AryA-65/smart-stat/renodus/Pictures/renodus_front.png

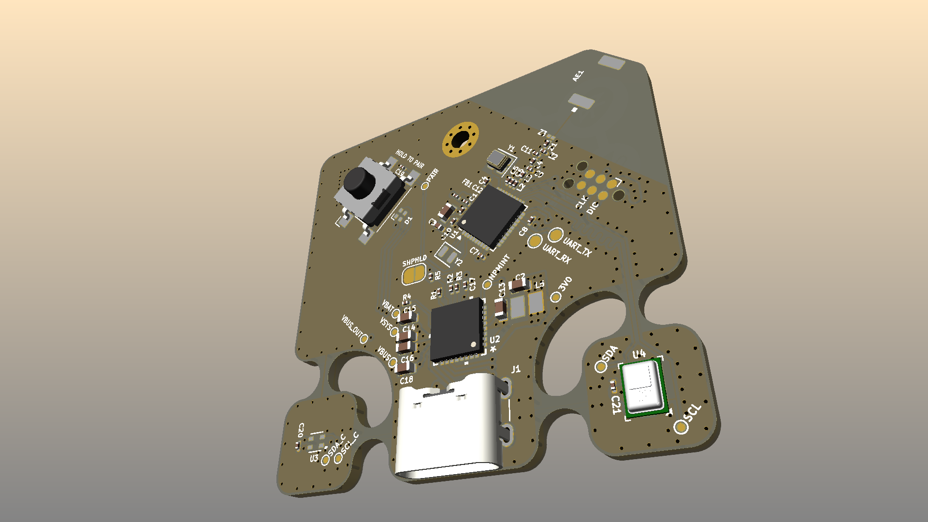
renodus/Pictures/renodus_front.png
