AryA-65/smart-stat/renodus/Pictures/renodus_back.png

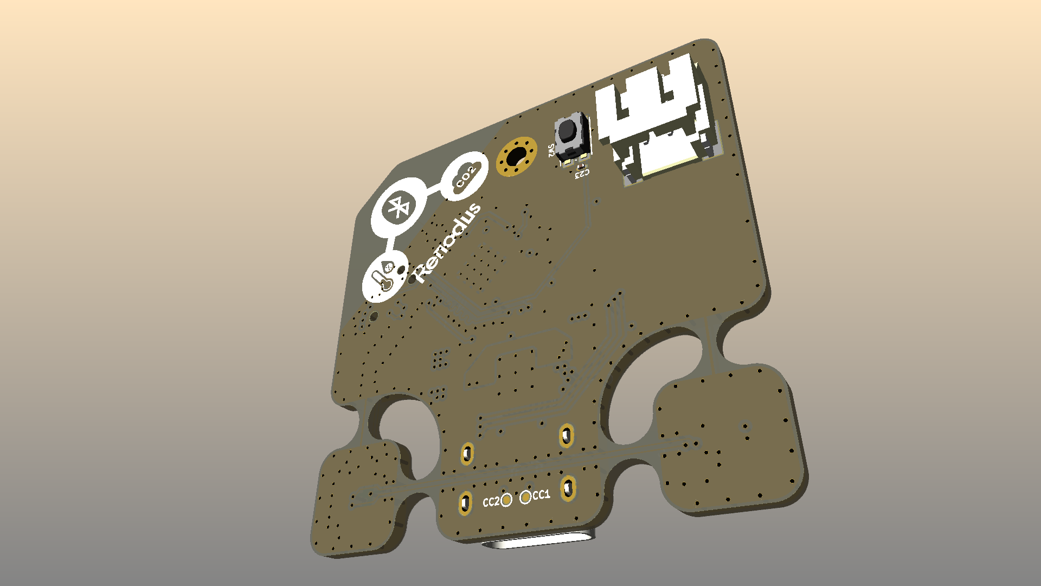
renodus/Pictures/renodus_back.png
