AryA-65/smart-stat/README.md

# smart-stat
Smart thermostat and bluetooth temperature sensors
