AryA-65/smart-stat/renodus/board.step

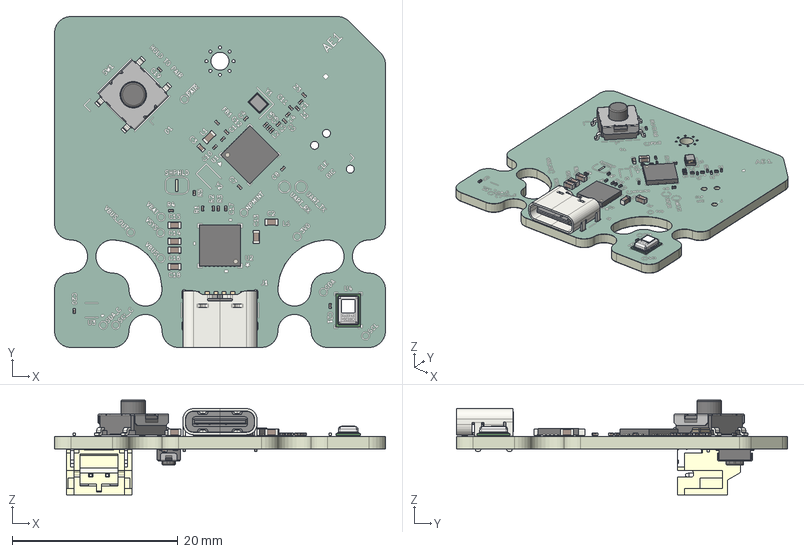
[picture p3: CAD file, 2026-07-10]
renodus/board.step
40.0 x 40.0 x 11.5 mm
C_0201_0603Metric x 27
C_0603_1608Metric x 7
USB_C_Receptacle_GCT_USB4125-xx-x_6P_TopMnt_Horizontal
Manoun_B01_BOARD_00
NYOS_BOND_8PADS_Nyos_ASIC-1_00
167450_Standard
167449_Standard
QFN-32-1EP_5x5mm_P0.5mm_EP3.7x3.7mm
QFN-40-1EP_5x5mm_Pitch0.4mm
SW_SPST_Omron_B3FS-101xP
Crystal_SMD_2016-4Pin_2.0x1.6mm
C_0402_1005Metric
SW_Push_1P1T_NO_CK_KMR2
S2B-PH-SM4-TB(LF)(SN)
renodus-unsaved-export-K5br5I_silkscreen x 2
renodus-unsaved-export-K5br5I_soldermask x 2
renodus-unsaved-export-K5br5I_PCB
