AryA-65/smart-stat/renodus/Production Files/3D Files/Button.3mf

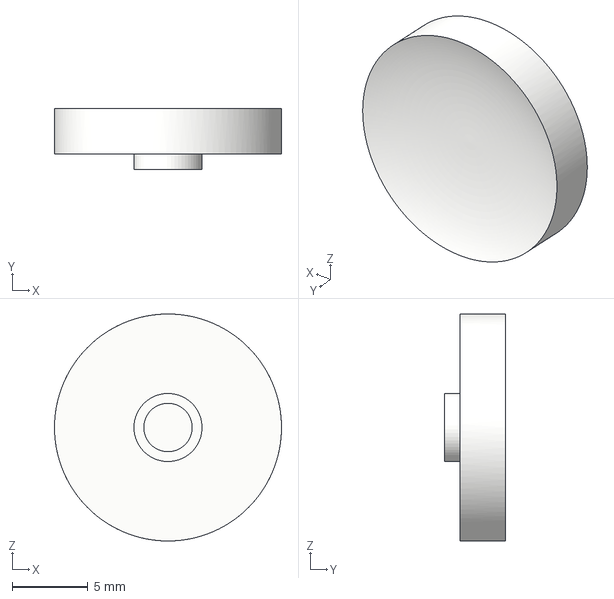
[picture p4: CAD file, 2026-07-21]
renodus/Production Files/3D Files/Button.3mf
15.0 x 4.00 x 15.0 mm
