AryA-65/smart-stat/renodus/Production Files/3D Files/Body (Rear).3mf

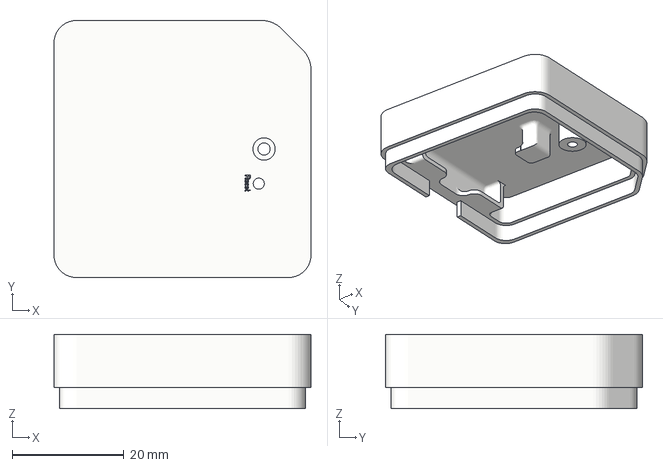
[picture p5: CAD file, 2026-07-10]
renodus/Production Files/3D Files/Body (Rear).3mf
46.0 x 46.0 x 13.3 mm
