AryA-65/smart-stat/renodus/Production Files/3D Files/Body (Front).3mf

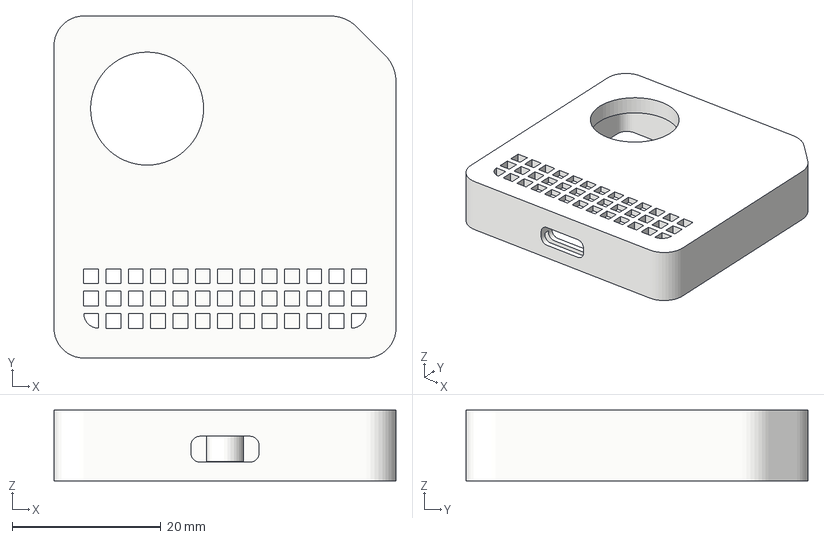
[picture p6: CAD file, 2026-07-10]
renodus/Production Files/3D Files/Body (Front).3mf
46.0 x 46.0 x 9.50 mm
