AryA-65/smart-stat/renodus/Production Files/renodus_schematic.pdf

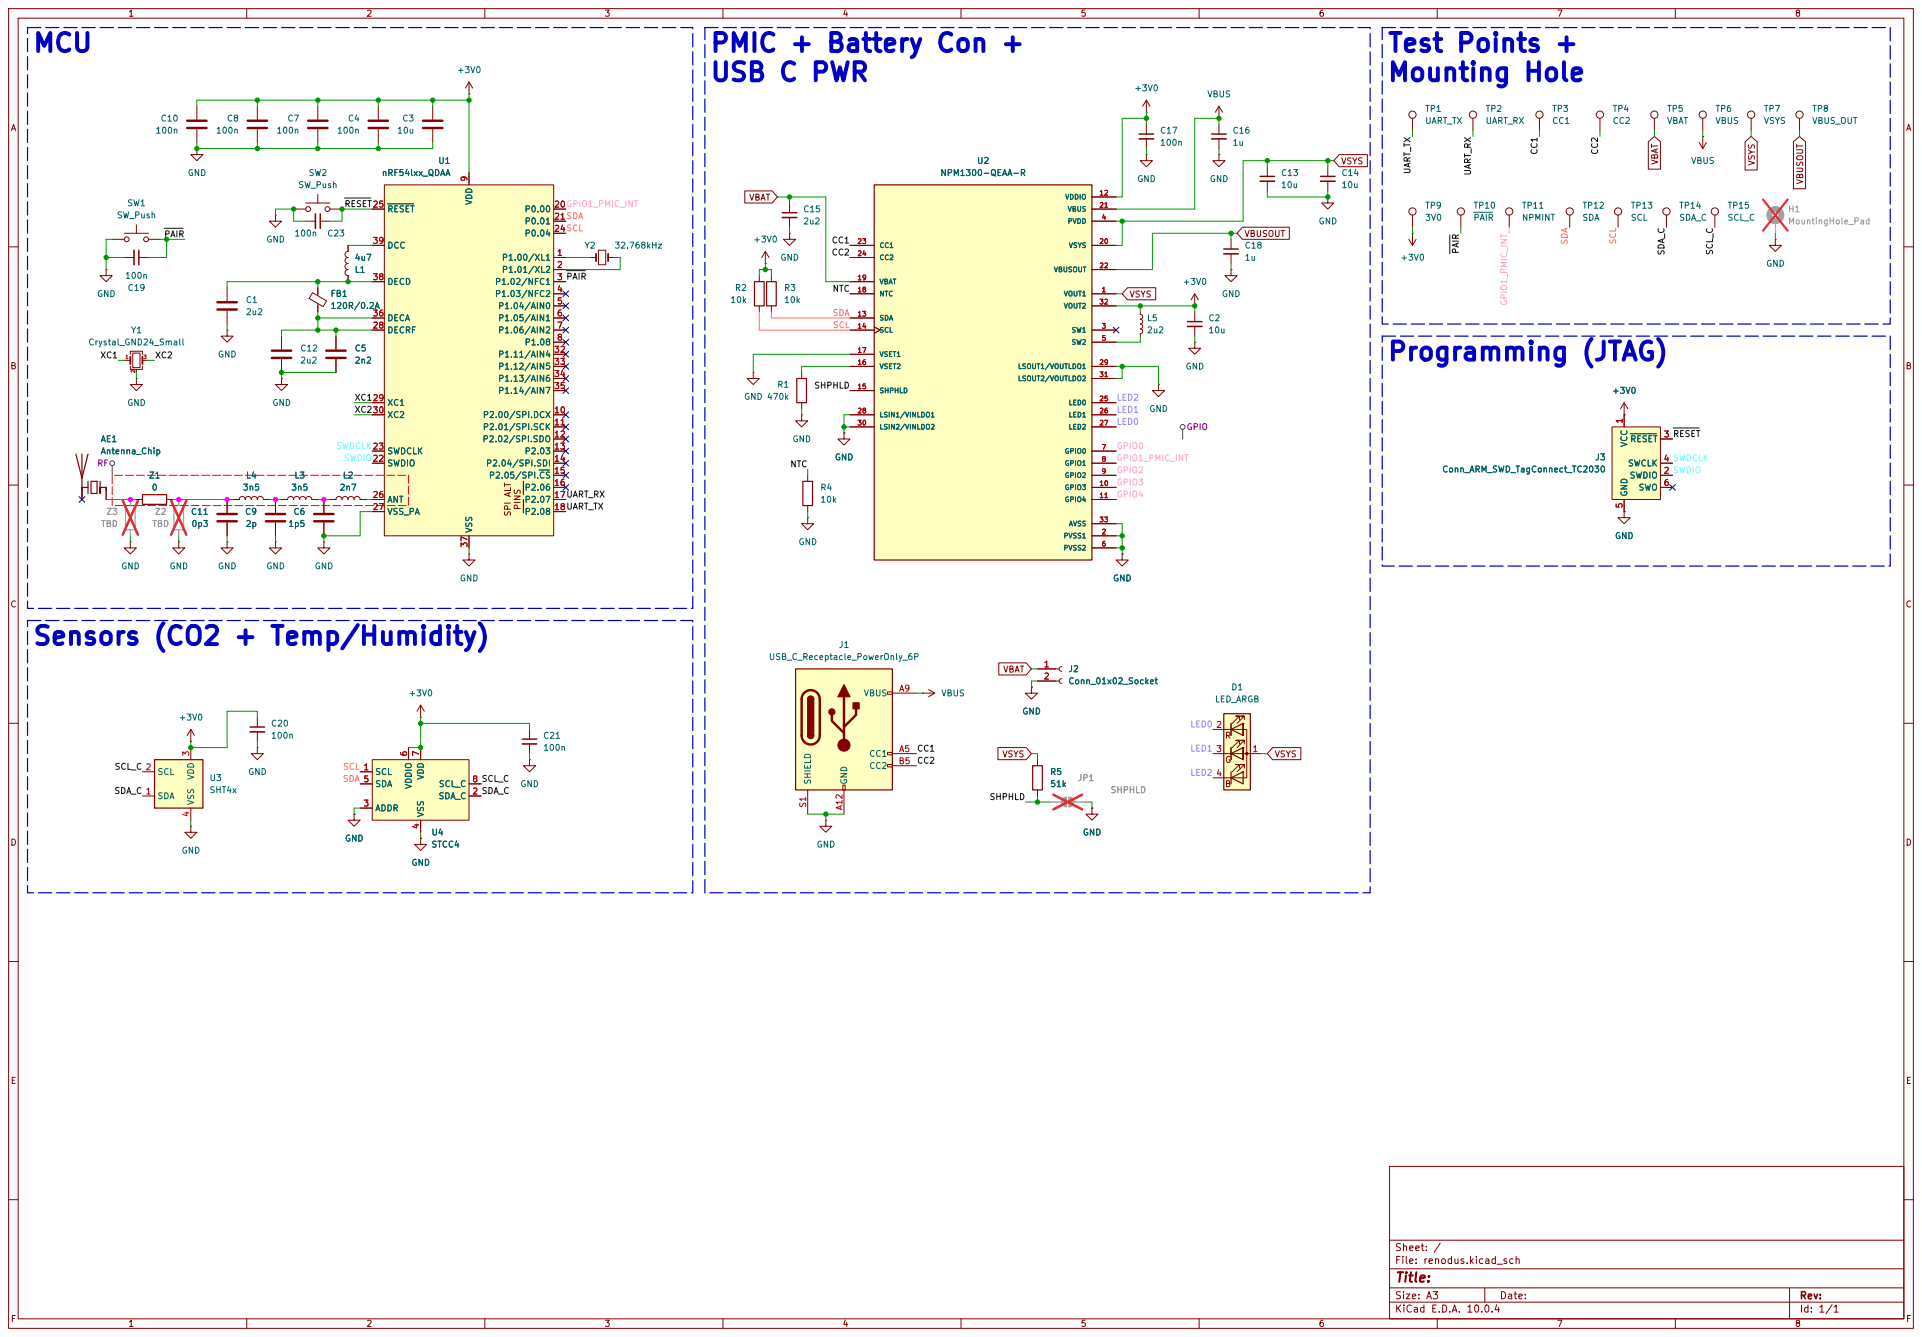
[picture p7: page 1]

9 P2.00/SPI.DCX 10 P2.01/SPI.SCK 11 P2.02/SPI.SDO 12 P2.03 13 P2.04/SPI.SDI 14 P2.05/SPI.CS 15 P2.06 16 P2.07 17 P2.08 18 P0.00 20 P0.01 21

Size: A3 | Rev: | F Date:
KiCad E.D.A. 10.0.4 | Id: 1/1
