AryA-65/smart-stat/renodus/renodus.kicad_pcb

## KiCad design renodus/renodus.kicad_pcb (2026-07-21)

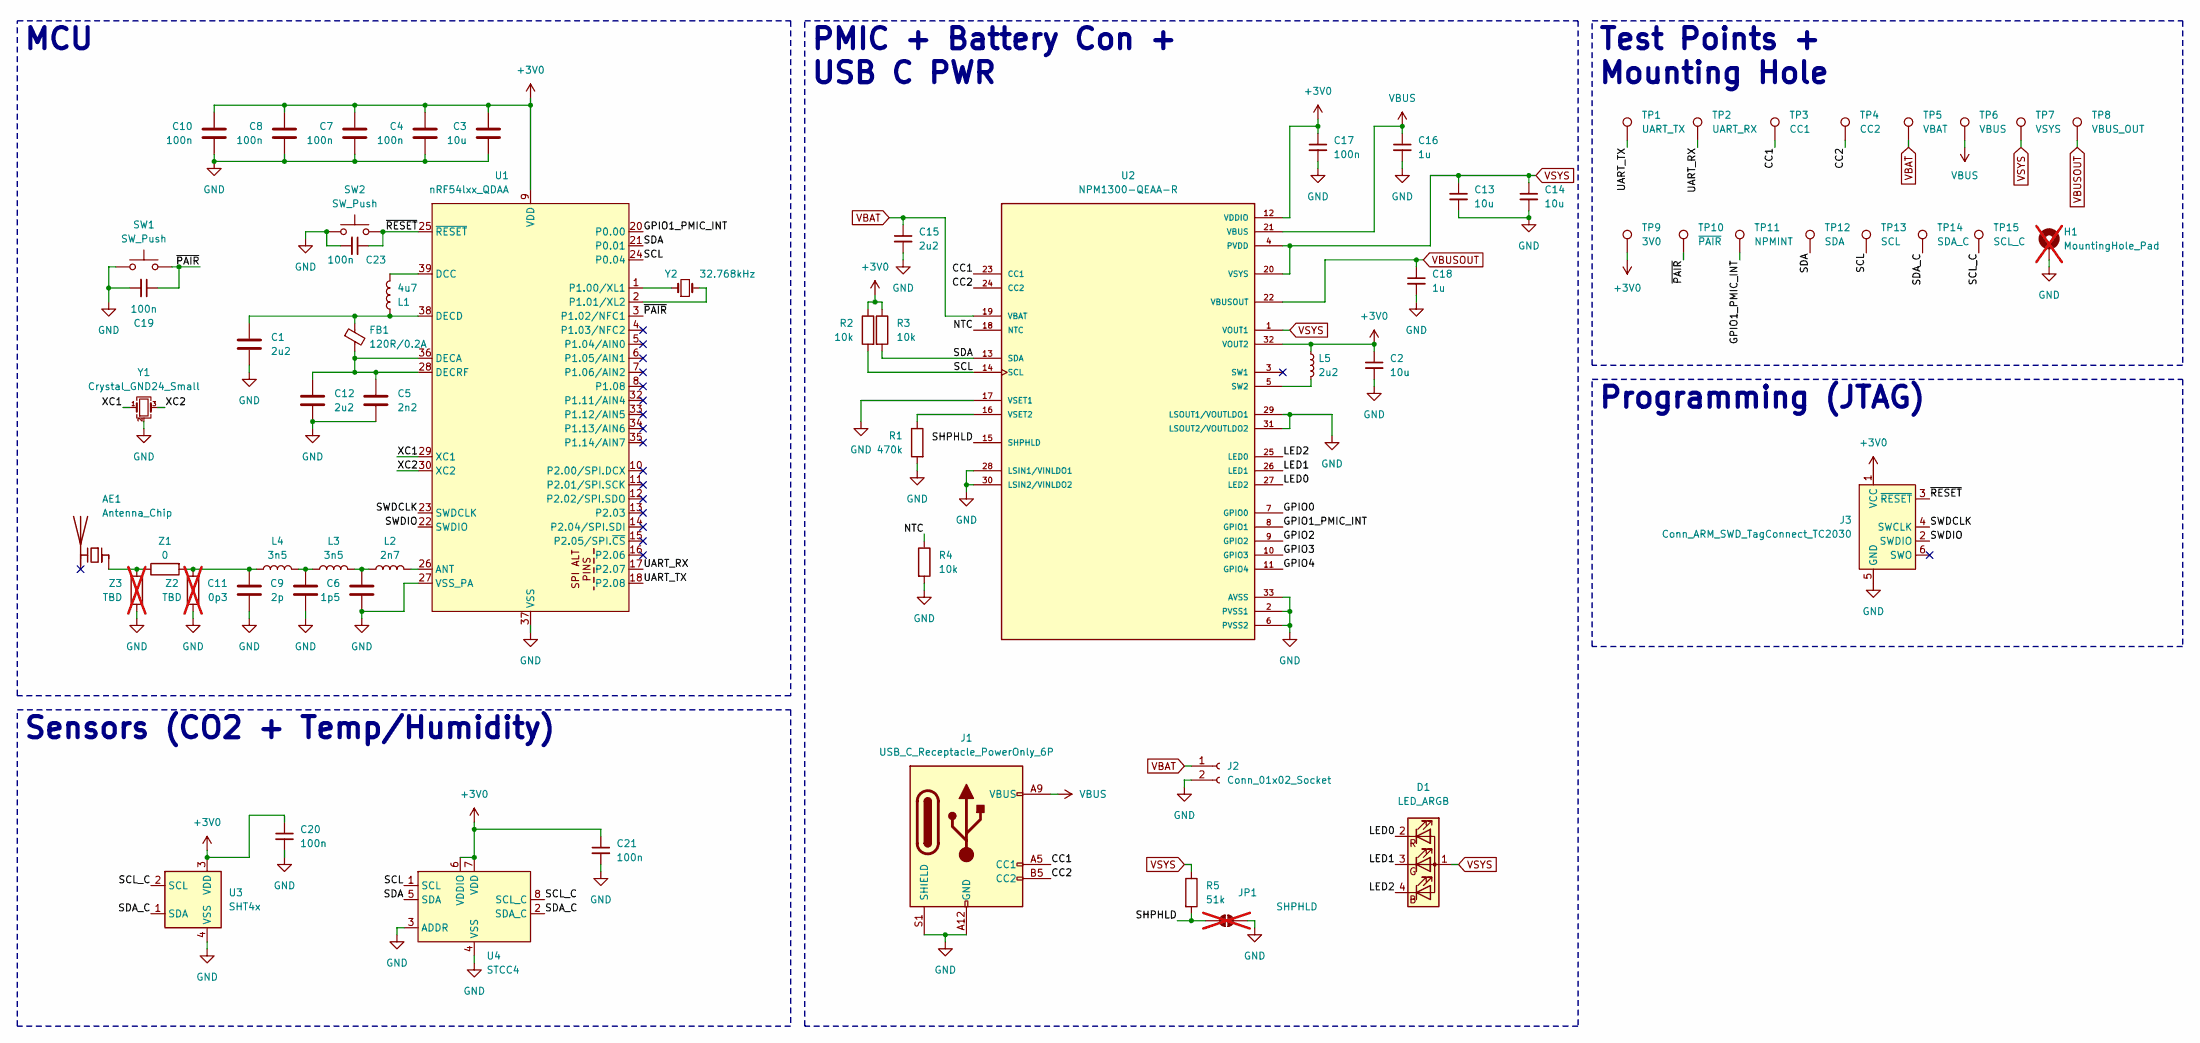
[picture p8: schematic renodus.kicad_sch]

Parts:
AE1: Antenna_Chip; AANI-CH-0129-T; Part Num. AANI-CH-0129-T
C1, C12: 2u2; 0201_universal; Part Num. GRM033R61A225KE47
C2, C13, C14: 10u; 0603_universal; Part Num. GRM188R61A106ME69J
C3: 10u; 0402_universal; Part Num. GRT155C80J106ME13J
C4, C7, C8, C10: 100n; 0201_universal; Part Num. GRM033Z71A104KE14D
C5: 2n2; 0201_universal; Part Num. GRM033R71A222KA01D
C6: 1p5; 0201_universal; Part Num. GJM0335C1E1R5WB01
C9: 2p; 0201_universal; Part Num. GJM0335C1E2R0WB01
C11: 0p3; 0201_universal; Part Num. GRM0335C1HR30BA01
C15: 2u2; 0603_universal; Part Num. GRM188R61E225KA12D
C16, C18: 1u; 0603_universal; Part Num. CL10A105KP8NNNC
C17, C19, C20, C21, C23: 100n; 0201_universal; Part Num. C0603X5R1E104K030BB
D1: LED_ARGB; LED_Wurth_150044M155260; Part Num. 150044M155260
FB1: 120R/0.2A; 0201_universal; Part Num. BLM03AG121SN1D
H1: MountingHole_Pad; MountingHole_2.2mm_M2_Pad_Via; not fitted
J1: USB_C_Receptacle_PowerOnly_6P; USB_C_Receptacle_GCT_USB4125-xx-x-0190_6P_TopMnt_Horizontal; Part Num. USB4125-GF-A
J2: Conn_01x02_Socket; JST_S2B-PH-SM4-TB; Part Num. S2B-PH-SM4-TB
J3: Conn_ARM_SWD_TagConnect_TC2030; Tag-Connect_TC2030-IDC-NL_2x03_P1.27mm_Vertical
JP1: SHPHLD; SolderJumper-2_P1.3mm_Open_RoundedPad1.0x1.5mm; not fitted
L1: 4u7; 0603_universal; Part Num. MLZ1608M4R7WT000
L2: 2n7; 0201_universal; Part Num. LQP03HQ2N7B02
L3, L4: 3n5; 0201_universal; Part Num. LQP03HQ3N5B02
L5: 2u2; INDC2016X100N; Part Num. CIGT201610EH2R2MNE
R1: 470k; 0201_universal; Part Num. ERJ-1GNF4703C
R2, R3, R4: 10k; 0201_universal; Part Num. RC0201FR-0710KL
R5: 51k; 0201_universal; Part Num. RC0201JR-0751KL
SW1: SW_Push; SW_SPST_Omron_B3FS-101xP; Part Num. B3FS-1012P
SW2: SW_Push; SW_Push_1P1T_NO_CK_KMR2; Part Num. KMR231G LFS
TP1: UART_TX; TestPoint_Pad_D1.0mm
TP2: UART_RX; TestPoint_Pad_D1.0mm
TP3: CC1; TestPoint_Pad_D0.5mm
TP4: CC2; TestPoint_Pad_D0.5mm
TP5: VBAT; TestPoint_Pad_D0.5mm
TP6: VBUS; TestPoint_Pad_D0.5mm
TP7: VSYS; TestPoint_Pad_D0.5mm
TP8: VBUS_OUT; TestPoint_Pad_D0.5mm
TP9: 3V0; TestPoint_Pad_D0.5mm
TP10: ~{PAIR}; TestPoint_Pad_D0.5mm
TP11: NPMINT; TestPoint_Pad_D0.5mm
TP12: SDA; TestPoint_Pad_D0.5mm
TP13: SCL; TestPoint_Pad_D0.5mm
TP14: SDA_C; TestPoint_Pad_D0.5mm
TP15: SCL_C; TestPoint_Pad_D0.5mm
U1: nRF54lxx_QDAA; QFN-40-1EP_5x5mm_P0.4mm_EP3.6x3.6mm_ThermalVias; Part Num. NRF54L10-QDAA-R7
U2: NPM1300-QEAA-R; QFN32_5X5_NOR-L; PARTREV v1.1
U3: SHT4x; Sensirion_DFN-4_1.5x1.5mm_P0.8mm_SHT4x_NoCentralPad; Part Num. SHT41A-AW1B-R3
U4: STCC4; Part Num. STCC4-D-R3
Y1: Crystal_GND24_Small; Crystal_SMD_2016-4Pin_2.0x1.6mm; Part Num. CX2016DB32000D0WZRC1
Y2: 32.768kHz; Crystal_SMD_2012-2Pin_2.0x1.2mm; Part Num. 9HT11-32.768KDZC-T
Z1: 0; 0201_universal; Part Num. RC0201JR-070RL
Z2, Z3: TBD; 0201_universal; not fitted

Connections:
+3V0: C2.1, C3.1, C4.1, C7.1, C8.1, C10.1, C17.1, C20.1, C21.1, J3.1 (VCC), L5.1, R2.1, R3.1, TP9.1 (1_1), U1.9 (VDD), U1.19 (VDD), U1.31 (VDD), U1.40 (VDD), U2.12 (VDDIO), U2.32 (VOUT2), U3.3 (VDD), U4.6 (VDDIO), U4.7 (VDD)
/CC1: J1.A5 (CC1), TP3.1 (1_1), U2.23 (CC1)
/CC2: J1.B5 (CC2), TP4.1 (1_1), U2.24 (CC2)
/GPIO0: U2.7 (GPIO0)
/GPIO1_PMIC_INT: TP11.1 (1_1), U1.20 (P0.00), U2.8 (GPIO1)
/GPIO2: U2.9 (GPIO2)
/GPIO3: U2.10 (GPIO3)
/GPIO4: U2.11 (GPIO4)
/LED0: D1.2 (RK), U2.27 (LED2)
/LED1: D1.3 (GK), U2.26 (LED1)
/LED2: D1.4 (BK), U2.25 (LED0)
/NTC: R4.1, U2.18 (NTC)
/SCL: R2.2, TP13.1 (1_1), U1.24 (P0.04), U2.14 (SCL), U4.1 (SCL)
/SCL_C: TP15.1 (1_1), U3.2 (SCL), U4.8 (SCL_C)
/SDA: R3.2, TP12.1 (1_1), U1.21 (P0.01), U2.13 (SDA), U4.5 (SDA)
/SDA_C: TP14.1 (1_1), U3.1 (SDA), U4.2 (SDA_C)
/SHPHLD: JP1.1 (A), R5.2, U2.15 (SHPHLD)
/SWDCLK: J3.4 (SWCLK), U1.23 (SWDCLK)
/SWDIO: J3.2 (SWDIO), U1.22 (SWDIO)
/UART_RX: TP2.1 (1_1), U1.17 (P2.07)
/UART_TX: TP1.1 (1_1), U1.18 (P2.08)
/XC1: U1.29 (XC1), Y1.1
/XC2: U1.30 (XC2), Y1.3
/~PAIR: C19.1, SW1.2, TP10.1 (1_1), U1.3 (P1.02/NFC1)
/~RESET: C23.1, J3.3 (~RESET), SW2.2, U1.25 (~RESET)
GND: C1.2, C2.2, C3.2, C4.2, C5.2, C6.2, C7.2, C8.2, C9.2, C10.2, C11.2, C12.2, C13.2, C14.2, C15.2, C16.2, C17.2, C18.2, C19.2, C20.2, C21.2, C23.2, H1.1 (1_1), J1.A12 (GND), J1.B12 (GND), J1.S1 (SHIELD), J2.2, J3.5 (GND), JP1.2 (B), R1.2, R4.2, SW1.1, SW2.1, U1.27 (VSS_PA), U1.37 (VSS), U1.41 (VSS), U2.2 (PVSS1), U2.6 (PVSS2), U2.17 (VSET1), U2.28 (LSIN1/VINLDO1), U2.29 (LSOUT1/VOUTLDO1), U2.30 (LSIN2/VINLDO2), U2.31 (LSOUT2/VOUTLDO2), U2.33 (AVSS), U3.4 (VSS), U4.3 (ADDR), U4.4 (VSS), Y1.2 (G), Y1.4 (G), Z2.1, Z3.2
unnamed: AE1.1 (FEED_1), Z1.1, Z3.1
unnamed: C6.1, L2.1, L3.2
unnamed: C9.1, L3.1, L4.2
unnamed: C11.1, L4.1, Z1.2, Z2.2
unnamed: L2.2, U1.26 (ANT)
unnamed: L1.1, U1.39 (DCC)
unnamed: C5.1, C12.1, FB1.2, U1.28 (DECRF), U1.36 (DECA)
unnamed: C1.1, FB1.1, L1.2, U1.38 (DECD)
unnamed: U1.1 (P1.00/XL1), Y2.1
unnamed: U1.2 (P1.01/XL2), Y2.2
unnamed: L5.2, U2.5 (SW2)
unnamed: R1.1, U2.16 (VSET2)
VBAT: C15.1, J2.1, TP5.1 (1_1), U2.19 (VBAT)
VBUS: C16.1, J1.A9 (VBUS), J1.B9 (VBUS), TP6.1 (1_1), U2.21 (VBUS)
VBUSOUT: C18.1, TP8.1 (1_1), U2.22 (VBUSOUT)
VSYS: C13.1, C14.1, D1.1 (A), R5.1, TP7.1 (1_1), U2.1 (VOUT1), U2.4 (PVDD), U2.20 (VSYS)

Notes on the sheet:
MCU
Sensors (CO2 + Temp/Humidity)
PMIC + Battery Con + USB C PWR
Test Points + Mounting Hole
Programming (JTAG)

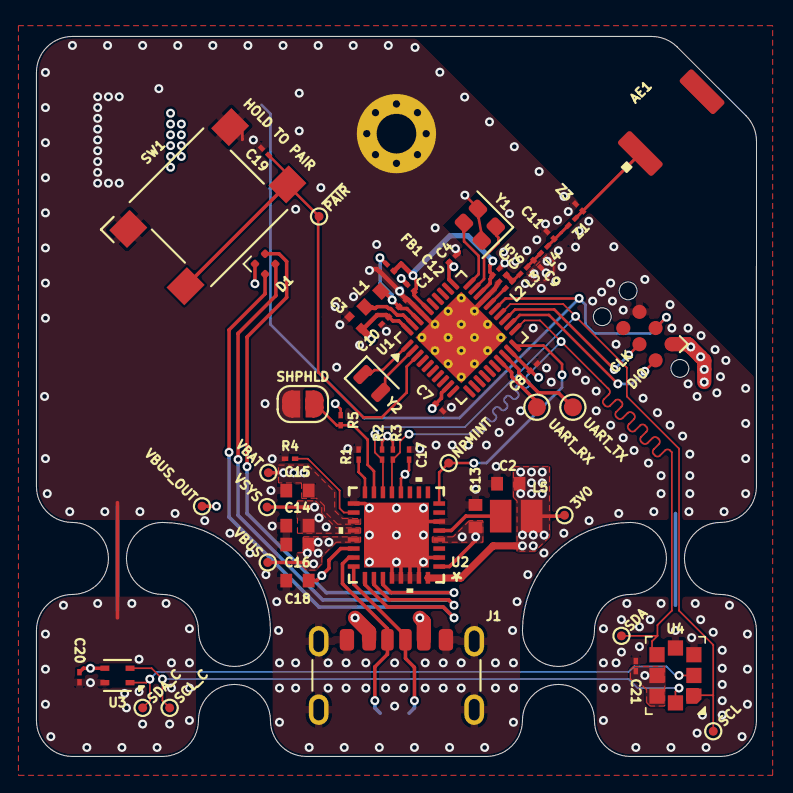
[picture p9: board renodus.kicad_pcb from above]

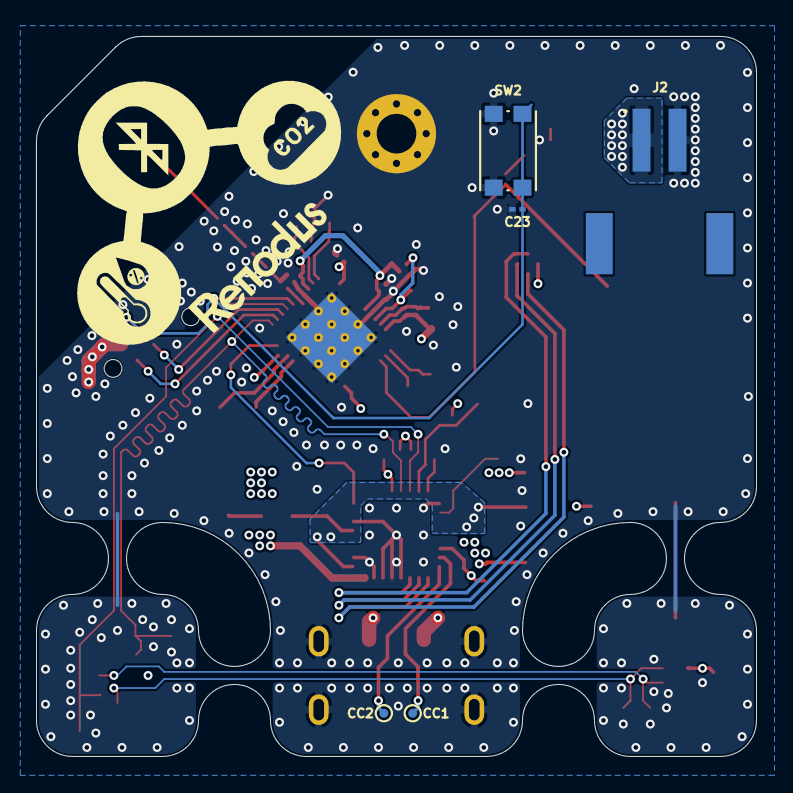
[picture p10: board renodus.kicad_pcb from below]

Board: 4 copper layers, 40.0 x 40.0 mm, 65 parts (5 on the bottom side), 38 nets.
