AryA-65/smart-stat/statimperium/statimperium.kicad_pcb

## KiCad design statimperium/statimperium.kicad_pcb (2026-07-07)

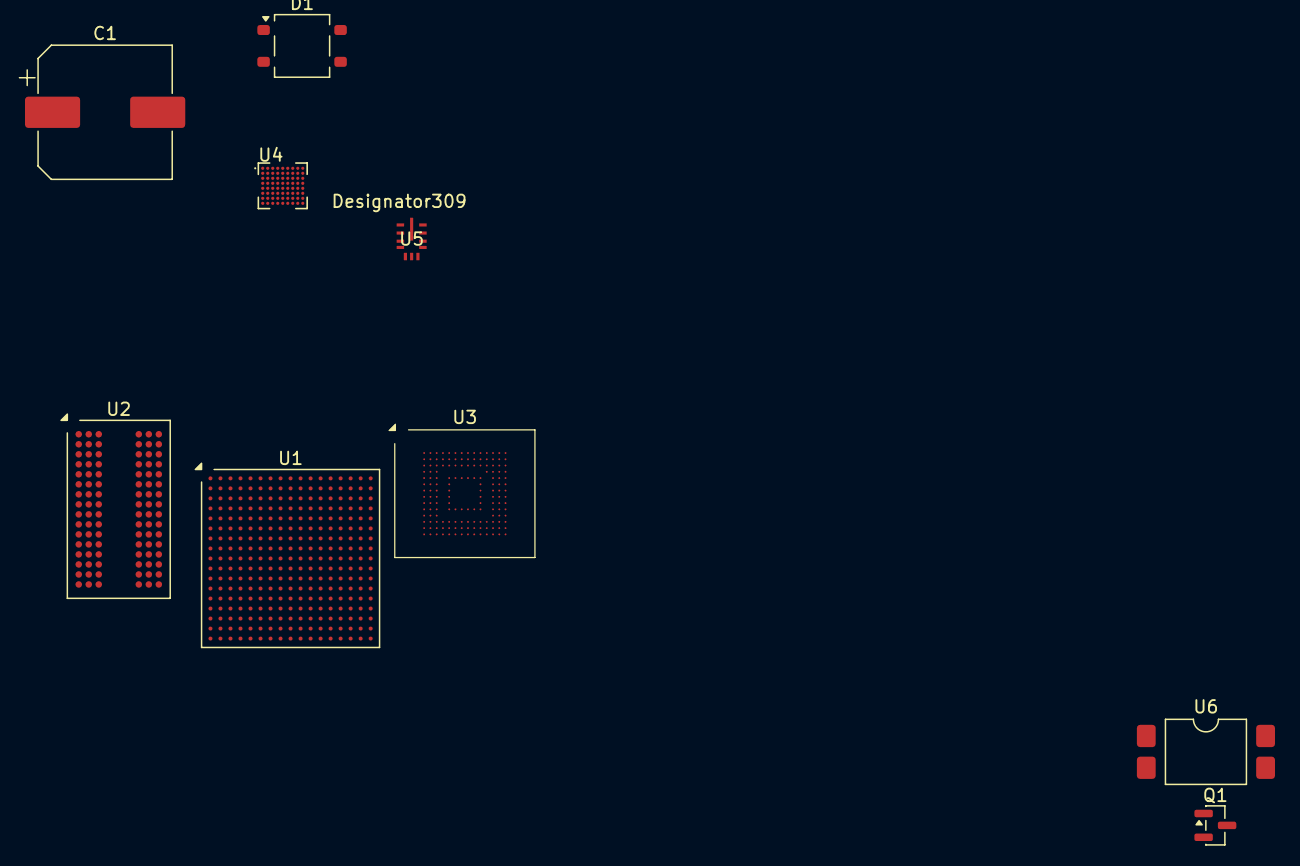
[picture p11: board statimperium.kicad_pcb from above]

Board: 2 copper layers, 9 parts (0 on the bottom side), 48 nets, no tracks yet.

Parts:
C1: C_Polarized_US; CP_Elec_10x10.5
D1: MB6S; TO-269AA
Q1: BSS138; SOT-23
U1: STM32MP135FAEx; LFBGA-289_14x14mm_Layout17x17_P0.8mm
U2: MT41K256M16TW; Micron_FBGA-96_8x14mm_Layout9x16_P0.8mm
U3: KLM4G1FETE-B041; BGA153_11x10mm_0.15mm
U4: MAX77818EWZ_T; BGA72N40P9X8_386X360X69N
U5: LMR36015ARNXR; RNX0012B
U6: SFH617A-1X007T; SMDIP-4_W9.53mm_Clearance8mm

Connections:
/MPU/A0: U1.G16 (DDR_A0), U2.N3 (A0)
/MPU/A1: U1.K15 (DDR_A1), U2.P7 (A1)
/MPU/A2: U1.F17 (DDR_A2), U2.P3 (A2)
/MPU/A3: U1.G15 (DDR_A3), U2.N2 (A3)
/MPU/A4: U1.M14 (DDR_A4), U2.P8 (A4)
/MPU/A5: U1.E16 (DDR_A5), U2.P2 (A5)
/MPU/A6: U1.M17 (DDR_A6), U2.R8 (A6)
/MPU/A7: U1.G14 (DDR_A7), U2.R2 (A7)
/MPU/A8: U1.L15 (DDR_A8), U2.T8 (A8)
/MPU/A9: U1.F16 (DDR_A9), U2.R3 (A9)
/MPU/A10: U1.J14 (DDR_A10), U2.L7 (A10/AP)
/MPU/A11: U1.K13 (DDR_A11), U2.R7 (A11)
/MPU/A12: U1.K17 (DDR_A12), U2.N7 (A12/~BC)
/MPU/A13: U1.F14 (DDR_A13), U2.T3 (A13)
/MPU/A14: U1.L17 (DDR_A14), U2.T7 (A14)
/MPU/DQ0: U1.B17 (DDR_DQ0), U2.E3 (DQ0)
/MPU/DQ1: U1.C15 (DDR_DQ1), U2.F7 (DQ1)
/MPU/DQ2: U1.E13 (DDR_DQ2), U2.F2 (DQ2)
/MPU/DQ3: U1.D17 (DDR_DQ3), U2.F8 (DQ3)
/MPU/DQ4: U1.B16 (DDR_DQ4), U2.H3 (DQ4)
/MPU/DQ5: U1.D16 (DDR_DQ5), U2.H8 (DQ5)
/MPU/DQ6: U1.E14 (DDR_DQ6), U2.G2 (DQ6)
/MPU/DQ7: U1.E15 (DDR_DQ7), U2.H7 (DQ7)
/MPU/DQ8: U1.N16 (DDR_DQ8), U2.D7 (DQ8)
/MPU/DQ9: U1.P17 (DDR_DQ9), U2.C3 (DQ9)
/MPU/DQ10: U1.N15 (DDR_DQ10), U2.C8 (DQ10)
/MPU/DQ11: U1.P15 (DDR_DQ11), U2.C2 (DQ11)
/MPU/DQ12: U1.R15 (DDR_DQ12), U2.A7 (DQ12)
/MPU/DQ13: U1.P16 (DDR_DQ13), U2.A2 (DQ13)
/MPU/DQ14: U1.T17 (DDR_DQ14), U2.B8 (DQ14)
/MPU/DQ15: U1.T16 (DDR_DQ15), U2.A3 (DQ15)
GND: U4.A6 (GND_Q), U4.D1 (GND_A), U4.D2 (GND_A), U4.D3 (GND_A), U4.D4 (GND_A), U4.D5 (GND_A), U4.E3 (GND_D)
unnamed: U1.A1 (VSS), U1.A17 (VSS), U1.C8 (VSS), U1.D3 (VSS), U1.D12 (VSS), U1.E5 (VSS), U1.F13 (VSS), U1.F15 (VSS), U1.G7 (VSS), U1.G8 (VSS), U1.G9 (VSS), U1.G10 (VSS), U1.G11 (VSS), U1.H7 (VSS), U1.H11 (VSS), U1.H14 (VSS), U1.J7 (VSS), U1.J9 (VSS), U1.J11 (VSS), U1.K3 (VSS), U1.K7 (VSS), U1.K11 (VSS), U1.L7 (VSS), U1.L8 (VSS), U1.L9 (VSS), U1.L10 (VSS), U1.L11 (VSS), U1.M15 (VSS), U1.N4 (VSS), U1.P11 (VSS), U1.R5 (VSS), U1.R8 (VSS), U1.U1 (VSS), U1.U17 (VSS)
unnamed: U2.A1 (V_{DDQ}), U2.A8 (V_{DDQ}), U2.C1 (V_{DDQ}), U2.C9 (V_{DDQ}), U2.D2 (V_{DDQ}), U2.E9 (V_{DDQ}), U2.F1 (V_{DDQ}), U2.H2 (V_{DDQ}), U2.H9 (V_{DDQ})
unnamed: U2.B2 (V_{DD}), U2.D9 (V_{DD}), U2.G7 (V_{DD}), U2.K2 (V_{DD}), U2.K8 (V_{DD}), U2.N1 (V_{DD}), U2.N9 (V_{DD}), U2.R1 (V_{DD}), U2.R9 (V_{DD})
unnamed: U2.B1 (V_{SSQ}), U2.B9 (V_{SSQ}), U2.D1 (V_{SSQ}), U2.D8 (V_{SSQ}), U2.E2 (V_{SSQ}), U2.E8 (V_{SSQ}), U2.F9 (V_{SSQ}), U2.G1 (V_{SSQ}), U2.G9 (V_{SSQ})
unnamed: U2.A9 (V_{SS}), U2.B3 (V_{SS}), U2.E1 (V_{SS}), U2.G8 (V_{SS}), U2.J2 (V_{SS}), U2.J8 (V_{SS}), U2.M1 (V_{SS}), U2.M9 (V_{SS}), U2.P1 (V_{SS}), U2.P9 (V_{SS}), U2.T1 (V_{SS}), U2.T9 (V_{SS})
unnamed: U4.G3 (BATT), U4.G4 (BATT), U4.H3 (BATT), U4.H4 (BATT)
unnamed: U4.B8 (BYP), U4.C7 (BYP), U4.D7 (BYP), U4.E8 (BYP), U4.E9 (BYP)
unnamed: U4.C8 (CHGIN), U4.C9 (CHGIN), U4.D8 (CHGIN), U4.D9 (CHGIN)
unnamed: U4.F8 (CHGLX), U4.F9 (CHGLX), U4.G8 (CHGLX), U4.G9 (CHGLX)
unnamed: U4.H7 (CHGPG), U4.H8 (CHGPG), U4.H9 (CHGPG)
unnamed: U4.E5 (SYS), U4.F5 (SYS), U4.G5 (SYS), U4.H5 (SYS), U4.H6 (SYS)
unnamed: U4.E1 (SYS_A), U4.F2 (SYS_A)
unnamed: U4.A7 (WCIN), U4.A8 (WCIN)
VCC: U3.E6 (VCC), U3.F5 (VCC), U3.J10 (VCC)
VCCQ: U3.C6 (VCCQ), U3.M4 (VCCQ), U3.N4 (VCCQ)
VSS: U3.A6 (VSS), U3.C4 (VSS), U3.E7 (VSS), U3.G5 (VSS), U3.H10 (VSS), U3.J5 (VSS), U3.N2 (VSS), U3.N5 (VSS)
