AryA-65/smart-stat/renodus/Pictures/Assembly.png

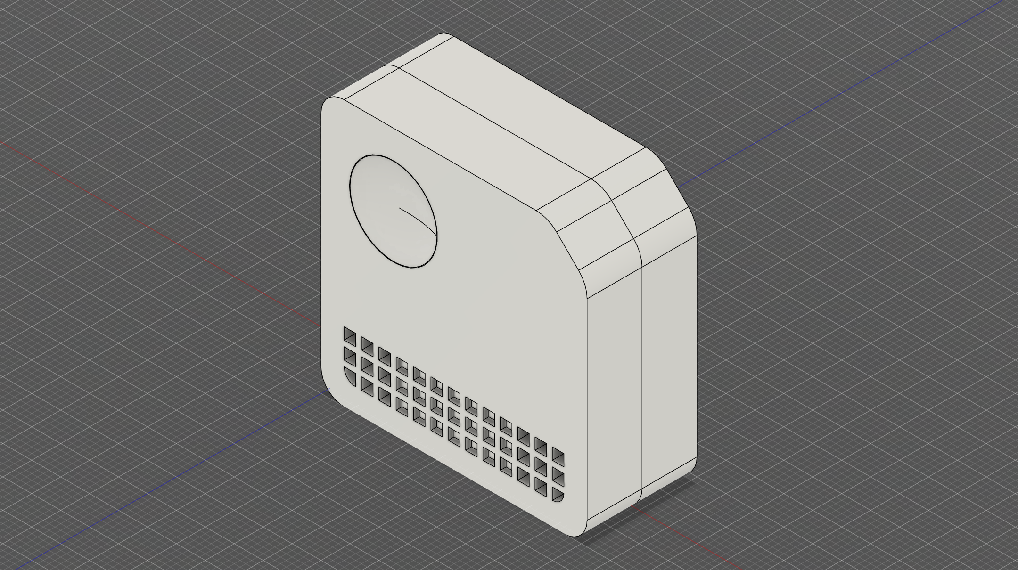
renodus/Pictures/Assembly.png
