AryA-65/smart-stat/(commit log)

2026-06-08 Initial commit (testing)
    [renodus.kicad_pcb, renodus.kicad_sch, statimperium.kicad_pcb, statimperium.kicad_sch]
2026-06-08 Replaced folder
    [statimperium.kicad_pcb, statimperium.kicad_sch]
2026-07-07 V1.0.a-1 complete
    [board.step, memory.kicad_sch, mpu_arch.kicad_sch, pwr_management.kicad_sch, renodus.kicad_pcb, renodus.kicad_sch, renodus_coincell.kicad_sch, statimperium.kicad_pcb]
2026-07-07 Button Position Modified
    [board.step, renodus.kicad_pcb, renodus_coincell.kicad_sch]
2026-07-10 Small update
    [Body (Front).3mf, Body (Rear).3mf, Button.3mf, renodus.kicad_pcb, renodus.kicad_sch, renodus_BOM.csv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]
2026-07-21 Fixed Gerbers
    [Button.3mf, renodus.kicad_pcb]
